laurareyma/IoT/Anexos/diagrama_bloques.png

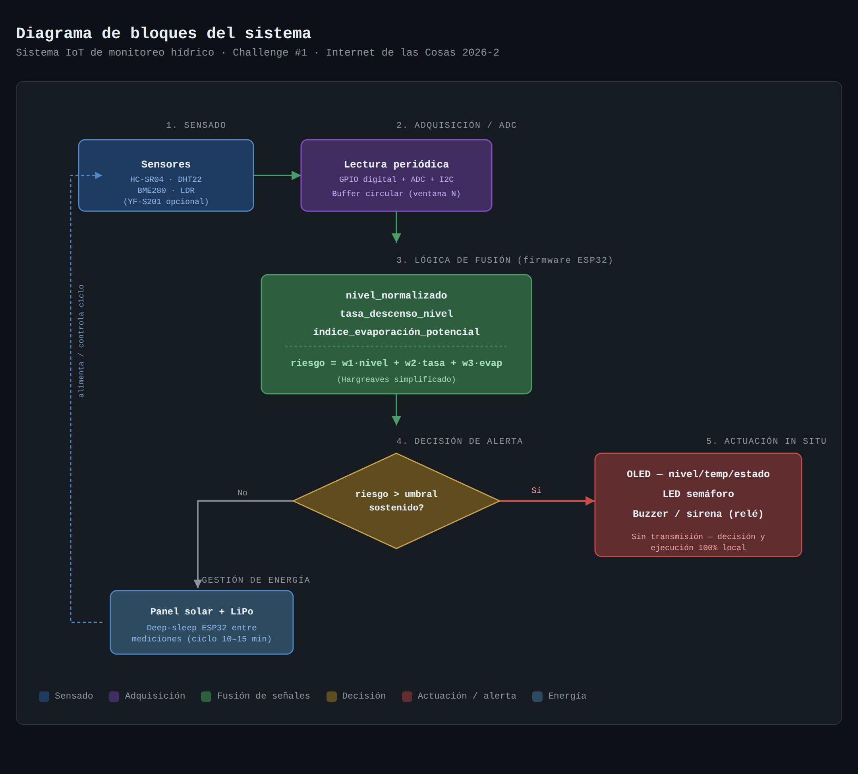
Anexos/diagrama_bloques.png
