laurareyma/IoT/Anexos/esquematico_esp32.png

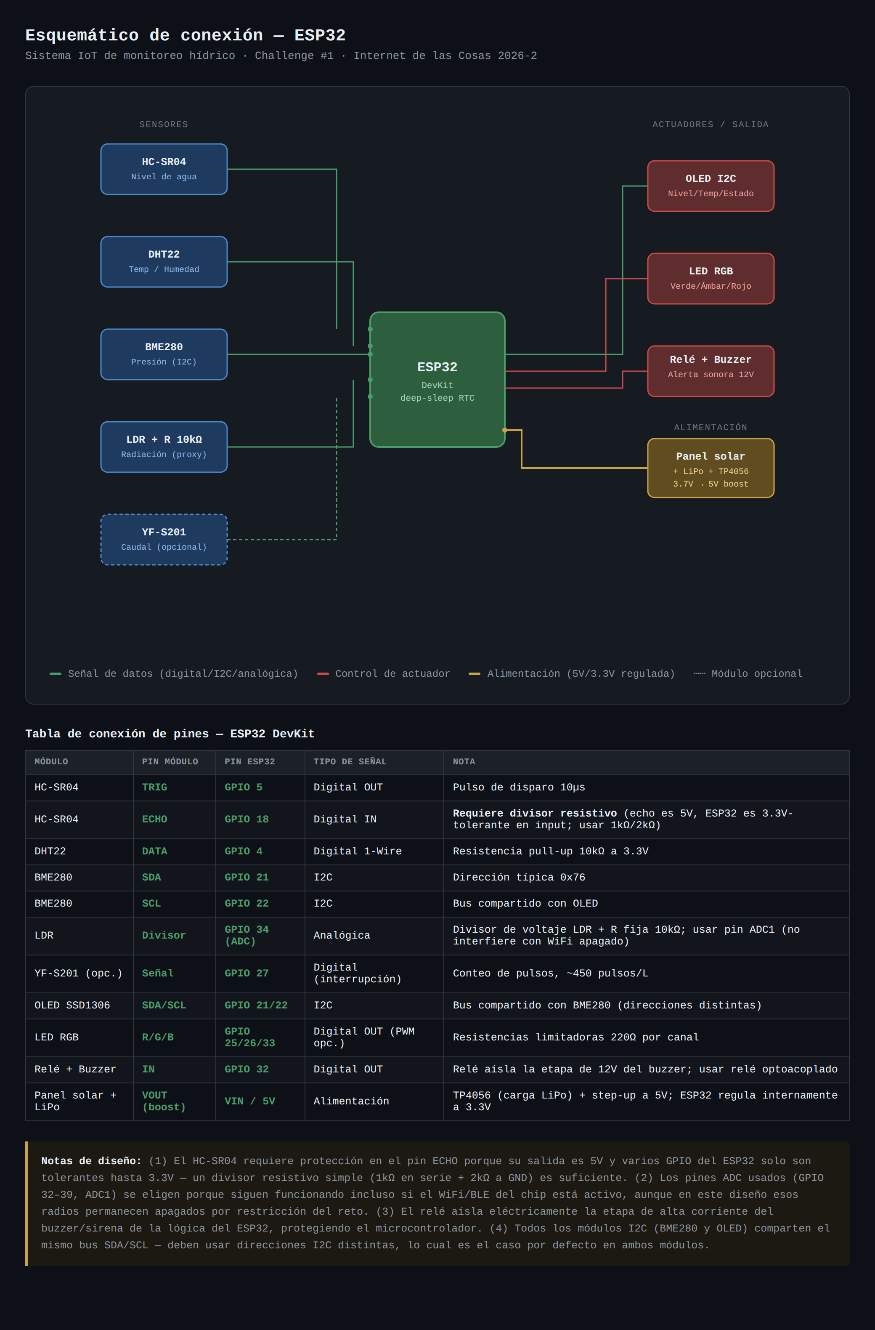
Anexos/esquematico_esp32.png
