laurareyma/IoT/(commit log)

2026-09-29 Agregar firmware del Challenge 2 y pruebas unitarias
    Firmware del nodo ESP32 (monitor_hidrico): medición con ISR + FreeRTOS,
    lógica de fusión, alarma física, histórico y tablero web con Digest.
    Incluye pruebas unitarias de la fusión y el script analizar_csv.py.
2026-11-09 Agregar el cliente MQTT del nodo ESP32 (Challenge 3)
    Basado en la primera versión de Ana María Cordero (PubSubClient).
    - TareaMQTT en su propia tarea FreeRTOS (núcleo 0, prioridad 1); loop()
    vuelve a solo vigilar el Wi-Fi.
    - Temas sabana/<nodo>/lectura, alerta, conexion (Last Will) y cmd/alarma.
    - Cola qMQTT para no perder cambios de alarma; alertas retenidas.
    - Silenciar y rearmar desde el tablero global vía gateway.
    - JSON de lectura igual al de /api/estado con el campo nodo.
    - Usuario y contraseña del broker opcionales en secrets.h.
    - mqtt_conectado en /api/diag; README con temas y errores de conexión.
    [config.h, monitor_hidrico.ino, mqtt_cliente.cpp, mqtt_cliente.h, servidor.cpp, servidor.h, sistema.h]
2026-11-09 Agregar el programa del gateway (Raspberry Pi)
    - gateway.py: Mosquitto (sabana/#) -> SQLite -> Ubidots (MQTT + TLS),
    promedio por minuto, cola pendientes sin internet, orden de silenciar
    desde Ubidots hacia el ESP32 y módulo de IA (regresión de horas hasta
    el nivel crítico + Gemini con plantilla si falla).
    - schema.sql con las tablas lecturas, eventos, predicciones y pendientes.
    - 19 pruebas de la lógica (test_gateway.py), sin red ni hardware.
    - Configuración de Mosquitto (listener, usuarios y ACL) y servicio systemd.
    - gateway.conf y la base de datos quedan fuera del repositorio.
2026-11-09 Agregar al README del gateway la guía de configuración de Ubidots
    Token, variables (incluida la variable de control silenciar), widgets del
    tablero global, evento de Telegram, acceso restringido, límite de datos
    del plan y verificación rápida con las pruebas N-02 a N-05.
2026-11-10 Enviar los avisos de la alarma por Telegram desde el gateway
    El plan de Ubidots no incluye la acción Telegram en sus eventos, así que
    el gateway envía los avisos con la API de bots de Telegram: cada cambio
    de estado de la alarma y la desconexión de un nodo, en un hilo propio y
    con 3 reintentos. Agrega la sección [telegram] a la configuración, la
    guía para crear el bot en el README y 5 pruebas.
2026-11-10 Agregar el README de la raíz del repositorio
